VCHSRobots/Pinball/Raspberry/assets/RobotParts_01.png

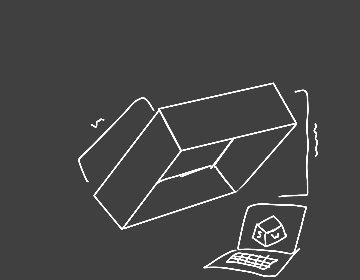
Raspberry/assets/RobotParts_01.png
