VCHSRobots/Pinball/Raspberry/assets/RobotParts_1.png

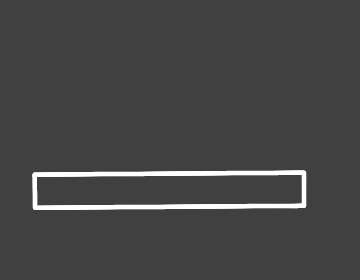
Raspberry/assets/RobotParts_1.png
