VCHSRobots/Pinball/Raspberry/assets/RobotParts_2.png

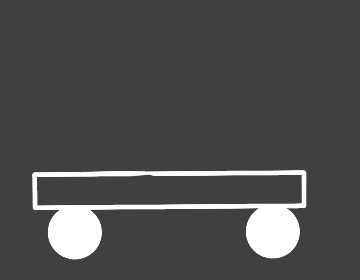
Raspberry/assets/RobotParts_2.png
