VCHSRobots/Pinball/Raspberry/assets/RobotParts_02.png

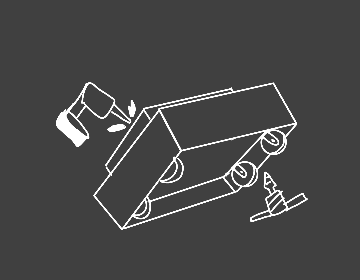
Raspberry/assets/RobotParts_02.png
