VCHSRobots/Pinball/Raspberry/assets/RobotParts_03.png

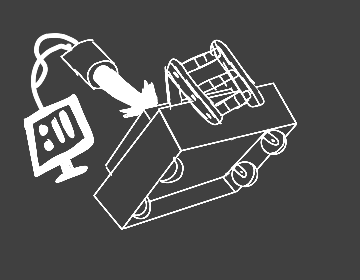
Raspberry/assets/RobotParts_03.png
