VCHSRobots/Pinball/Raspberry/assets/RobotParts_3.png

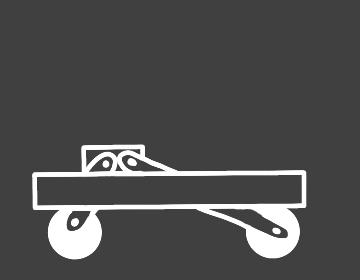
Raspberry/assets/RobotParts_3.png
