VCHSRobots/Pinball/Raspberry/assets/RobotParts_04.png

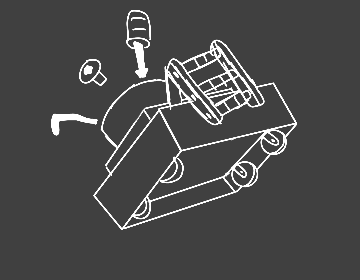
Raspberry/assets/RobotParts_04.png
