VCHSRobots/Pinball/Raspberry/assets/RobotParts_4.png

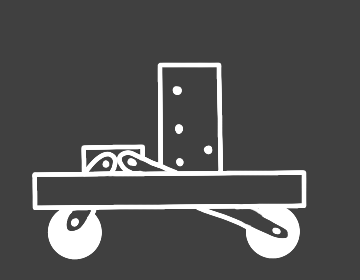
Raspberry/assets/RobotParts_4.png
