VCHSRobots/Pinball/Raspberry/assets/RobotParts_5.png

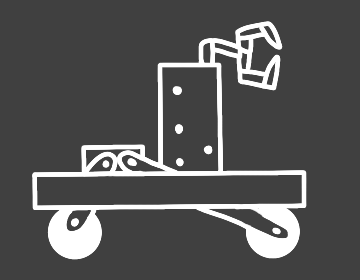
Raspberry/assets/RobotParts_5.png
