VCHSRobots/Pinball/Raspberry/assets/RobotParts_06.png

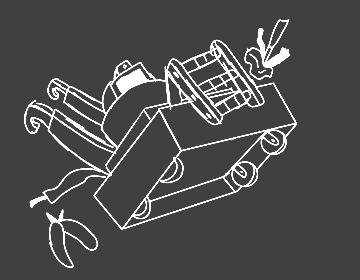
Raspberry/assets/RobotParts_06.png
