VCHSRobots/Pinball/Raspberry/assets/RobotParts_6.png

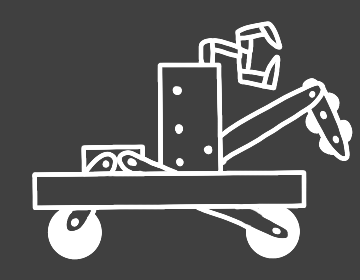
Raspberry/assets/RobotParts_6.png
