VCHSRobots/Pinball/Raspberry/assets/RobotParts_07.png

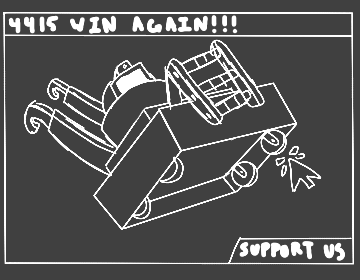
Raspberry/assets/RobotParts_07.png
