VCHSRobots/Pinball/Raspberry/assets/RobotParts_7.png

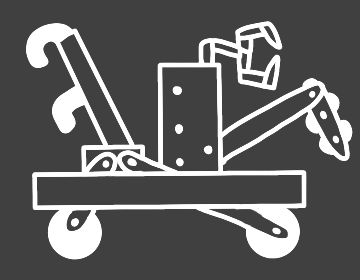
Raspberry/assets/RobotParts_7.png
