VCHSRobots/Pinball/Raspberry/assets/RobotParts_08.png

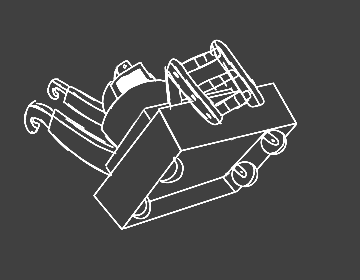
Raspberry/assets/RobotParts_08.png
