VCHSRobots/Pinball/Raspberry/assets/RobotParts_09.png

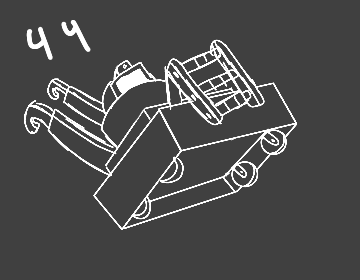
Raspberry/assets/RobotParts_09.png
