VCHSRobots/Pinball/Raspberry/assets/RobotParts_11.png

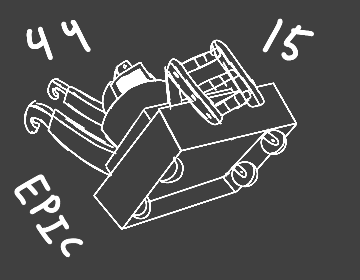
Raspberry/assets/RobotParts_11.png
