VCHSRobots/Pinball/Raspberry/assets/RobotParts_12.png

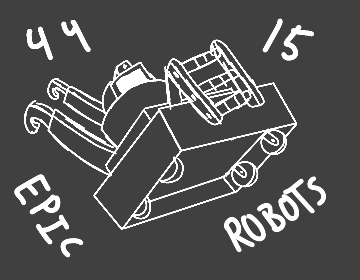
Raspberry/assets/RobotParts_12.png
