VCHSRobots/Pinball/(commit log)

2022-11-23 Flippers Node is done
    [Node_2_Lights.ino, Node_3_Lights.ino, Node_4_Flippers.ino, Node_9_Test.ino]
2022-12-02 flipper node with ball trough working
    [Ball_Trough_Unit.ino, Node_2_Lights.ino, Node_3_Lights.ino, Node_4_Flippers.ino]
2022-12-14 Panic Mode done. Light Node Bugs fixed.
    [Node_3_Lights.ino, config.py, game1.py, hardware.py, ledtst.py, logic_lanes.py, logic_panic.py, logic_targets.py]
